Tim-Gantumur/CASA-0014-Tim-Gantumur/images/00_concept_sketch.jpg

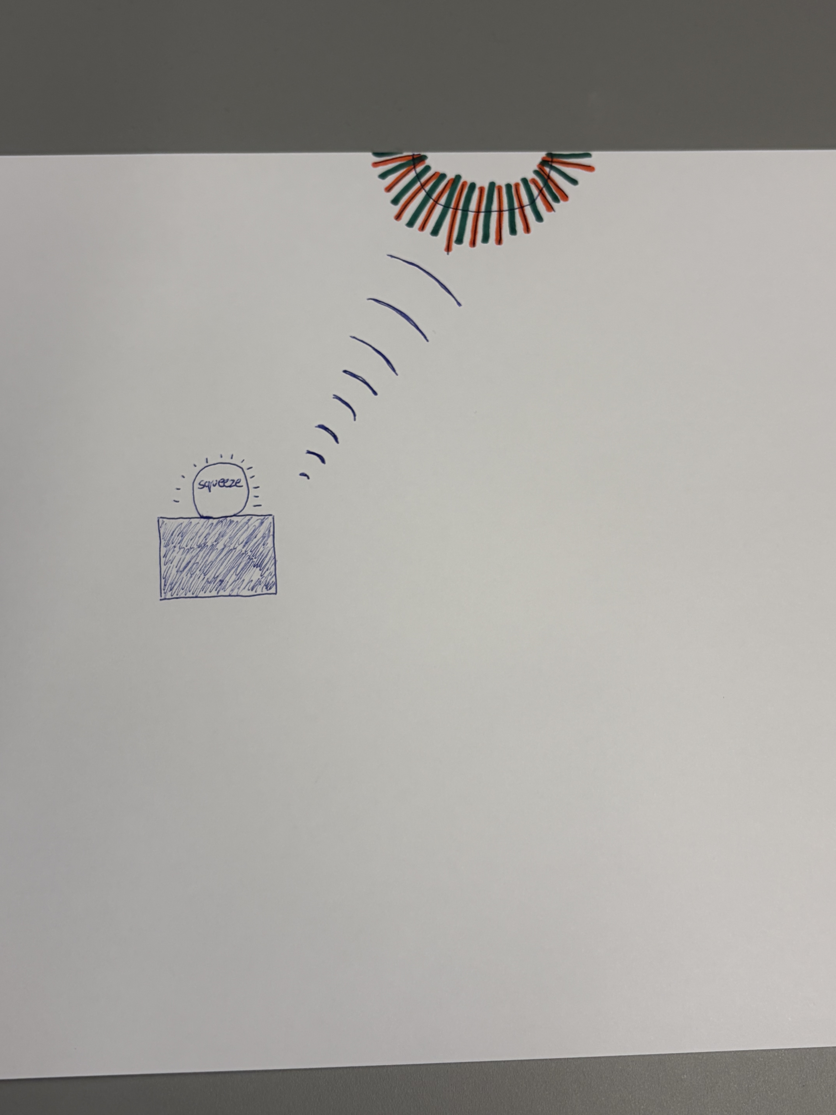
images/00_concept_sketch.jpg
