Tim-Gantumur/CASA-0014-Tim-Gantumur/images/02_mkr1010_on_breadboard .jpeg

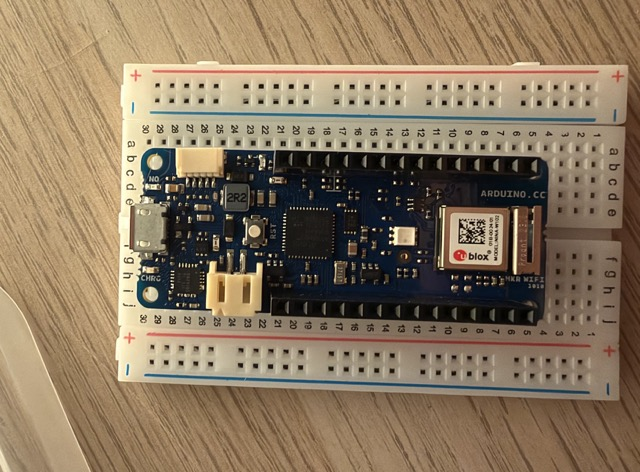
images/02_mkr1010_on_breadboard .jpeg
