Tim-Gantumur/CASA-0014-Tim-Gantumur/images/03_jumper_wires_on_sensor_legs .jpeg

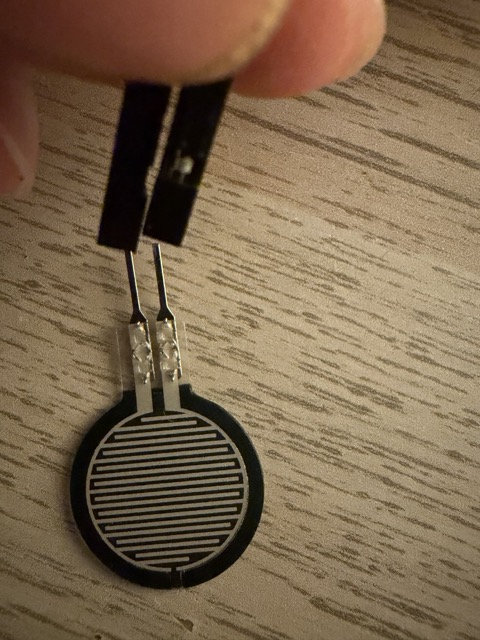
images/03_jumper_wires_on_sensor_legs .jpeg
