Tim-Gantumur/CASA-0014-Tim-Gantumur/images/06_serial_plotter_at_rest_2-3 .jpeg

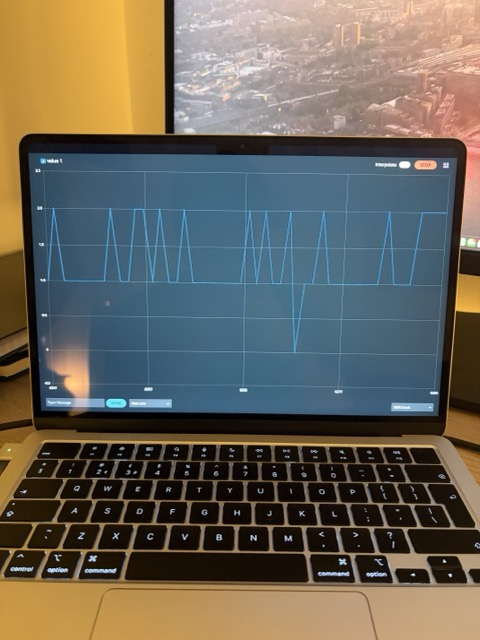
images/06_serial_plotter_at_rest_2-3 .jpeg
