Tim-Gantumur/CASA-0014-Tim-Gantumur/images/07_serial_plotter_squeeze_900 .jpeg

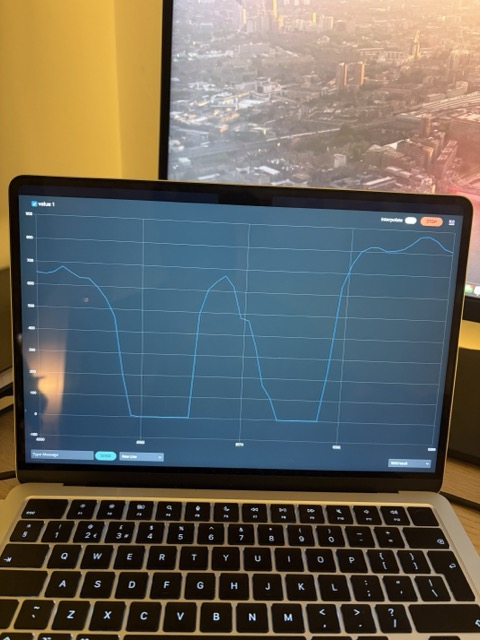
images/07_serial_plotter_squeeze_900 .jpeg
