Tim-Gantumur/CASA-0014-Tim-Gantumur/images/09_sensor_on_black_foam .jpeg

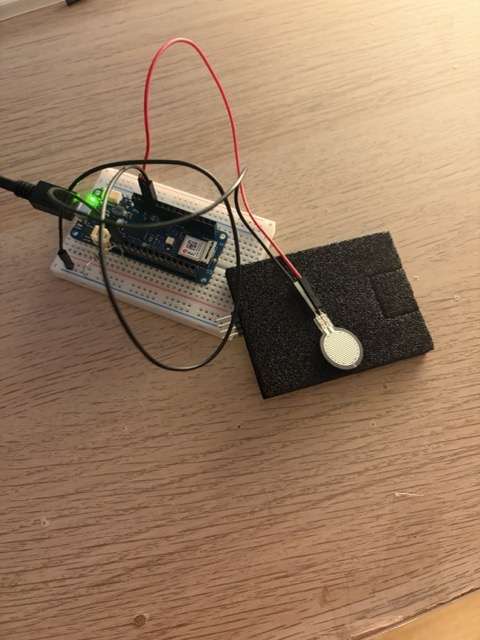
images/09_sensor_on_black_foam .jpeg
