Tim-Gantumur/CASA-0014-Tim-Gantumur/images/10_black_antistatic_foam .jpeg

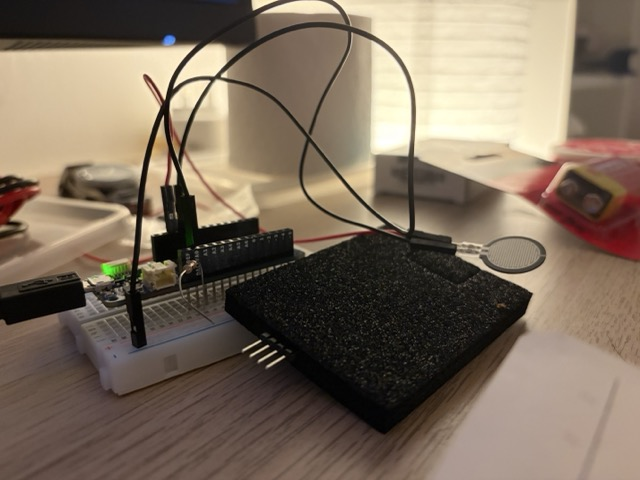
images/10_black_antistatic_foam .jpeg
