Tim-Gantumur/CASA-0014-Tim-Gantumur/images/11_practice_light_dim .jpeg

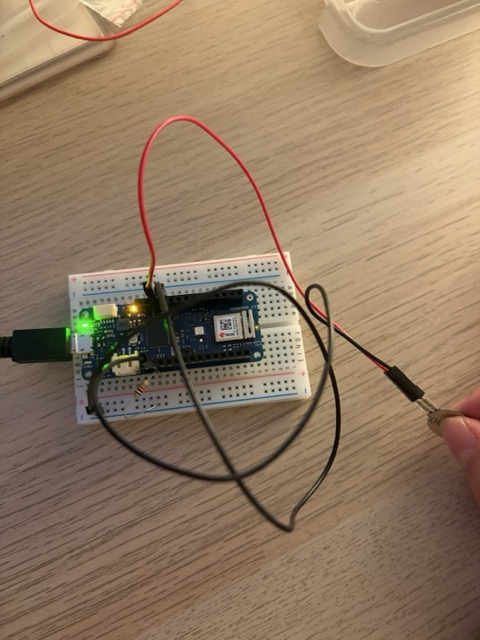
images/11_practice_light_dim .jpeg
