Tim-Gantumur/CASA-0014-Tim-Gantumur/images/12_practice_light_bright .jpeg

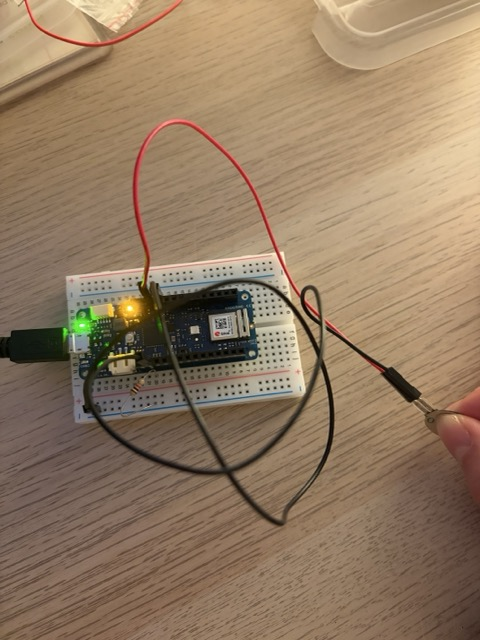
images/12_practice_light_bright .jpeg
