Tim-Gantumur/CASA-0014-Tim-Gantumur/images/13_resistor_coming_loose .jpeg

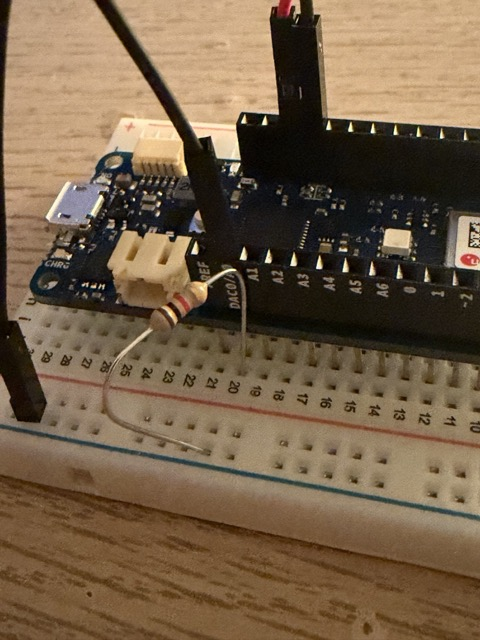
images/13_resistor_coming_loose .jpeg
