Tim-Gantumur/CASA-0014-Tim-Gantumur/images/14_battery .jpeg

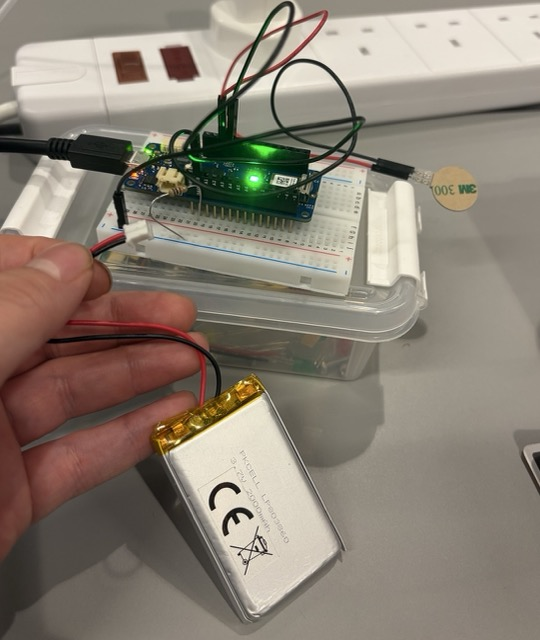
images/14_battery .jpeg
