Tim-Gantumur/CASA-0014-Tim-Gantumur/images/16_selector_dial_12 .jpeg

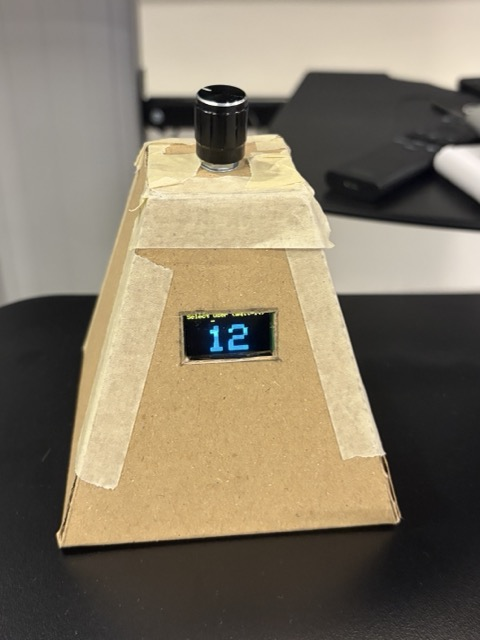
images/16_selector_dial_12 .jpeg
