Tim-Gantumur/CASA-0014-Tim-Gantumur/images/19_serial_monitor_levels.jpg

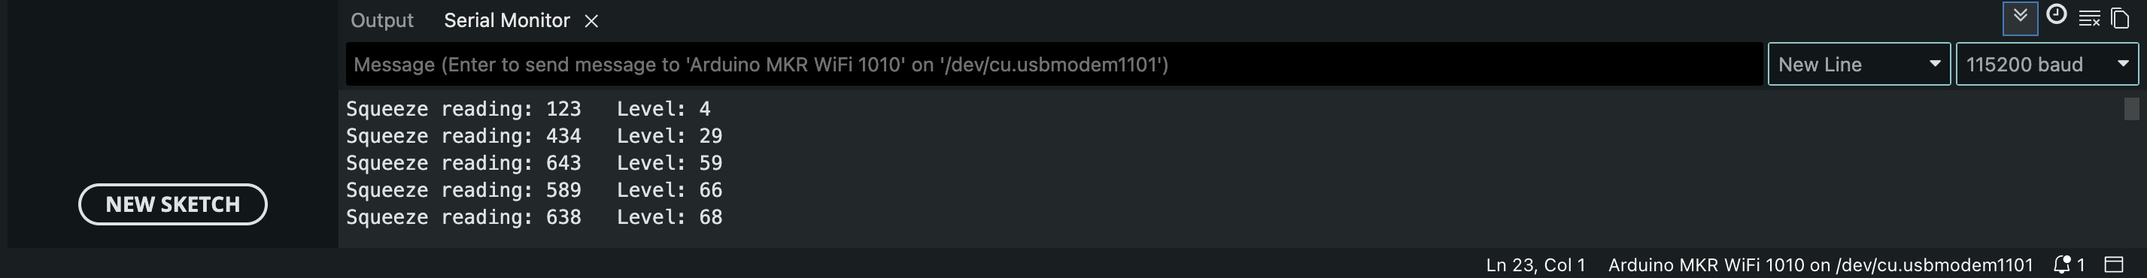
images/19_serial_monitor_levels.jpg
