Tim-Gantumur/CASA-0014-Tim-Gantumur/images/01_kit_parts .jpeg

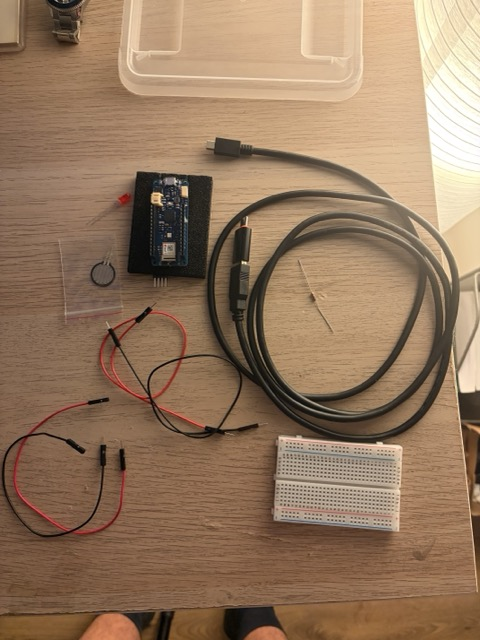
images/01_kit_parts .jpeg
