Tim-Gantumur/CASA-0014-Tim-Gantumur/images/04_first_build .jpeg

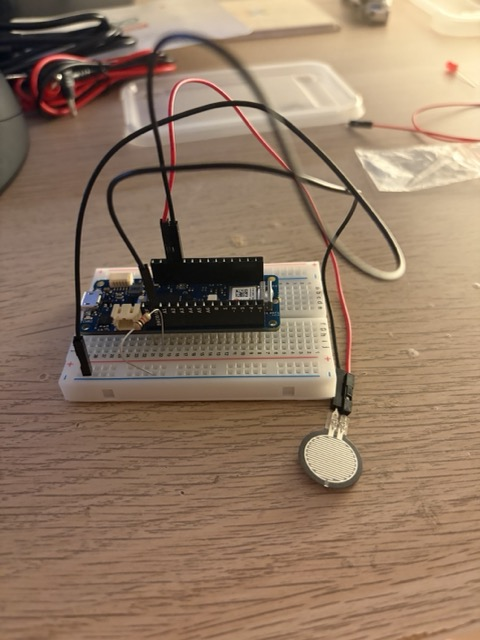
images/04_first_build .jpeg
