Tim-Gantumur/CASA-0014-Tim-Gantumur/squeeze_ball_vespera/arduino_secrets_example.h

// Template for passwords file.
// Make a copy called arduino_secrets.h and add the WiFi and MQTT details
// My real passwords file is kept off GitHub using .gitignore

#define SECRET_SSID     "wifi name"
#define SECRET_PASS     "wifi password"
#define SECRET_SSID1    "second wifi name"
#define SECRET_PASS1    "second wifi password"
#define SECRET_MQTTUSER "mqtt username"
#define SECRET_MQTTPASS "mqtt password"
