Tim-Gantumur/CASA-0014-Tim-Gantumur/(commit log)

2026-11-03 Add arduino_secrets.h and .DS_Store to .gitignore
2026-11-03 Add first sensor test sketch
2026-11-03 Add practice light sketch (onboard LED)
    Onboard light gets brighter the harder the sensor is squeezed. It ignores readings under 20.
2026-11-04 README – intro, video, how it works, flowchart
2026-11-04 Wiring diagram
